Jens-Si/Taranis-Poti-Switch-Mod/resistor-switch/2x_3-POS-SWITCH.jpg

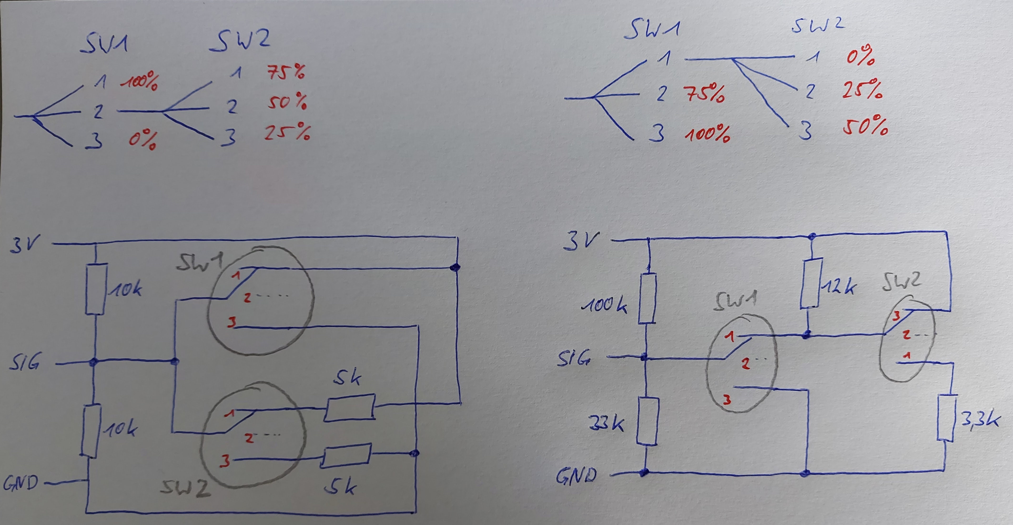
resistor-switch/2x_3-POS-SWITCH.jpg
