Jens-Si/Taranis-Poti-Switch-Mod/resistor-switch/3-POS-SWITCH.jpg

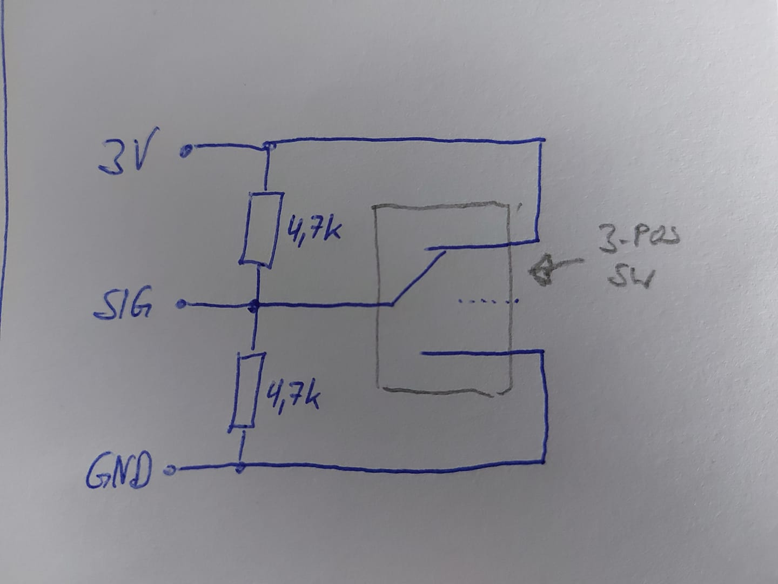
resistor-switch/3-POS-SWITCH.jpg
