Jens-Si/Taranis-Poti-Switch-Mod/(threads)

Thread 1 (2022-05-04):

wrong timer used!

Jens-Si, 2022-05-04:
Currently timer1 is used. This should be changed to timer4. With timer4 it is possible to achieve a much higher PWM frequency. This allows a smaller capacitor to be used and the signal should generally be lower noise.
